peddie/leitshow/README.md

leitshow
========

Light show PCBs (and code?)
