peddie/leitshow/leit-proto-1.brd

## EAGLE design leit-proto-1.brd (2013-08-19)

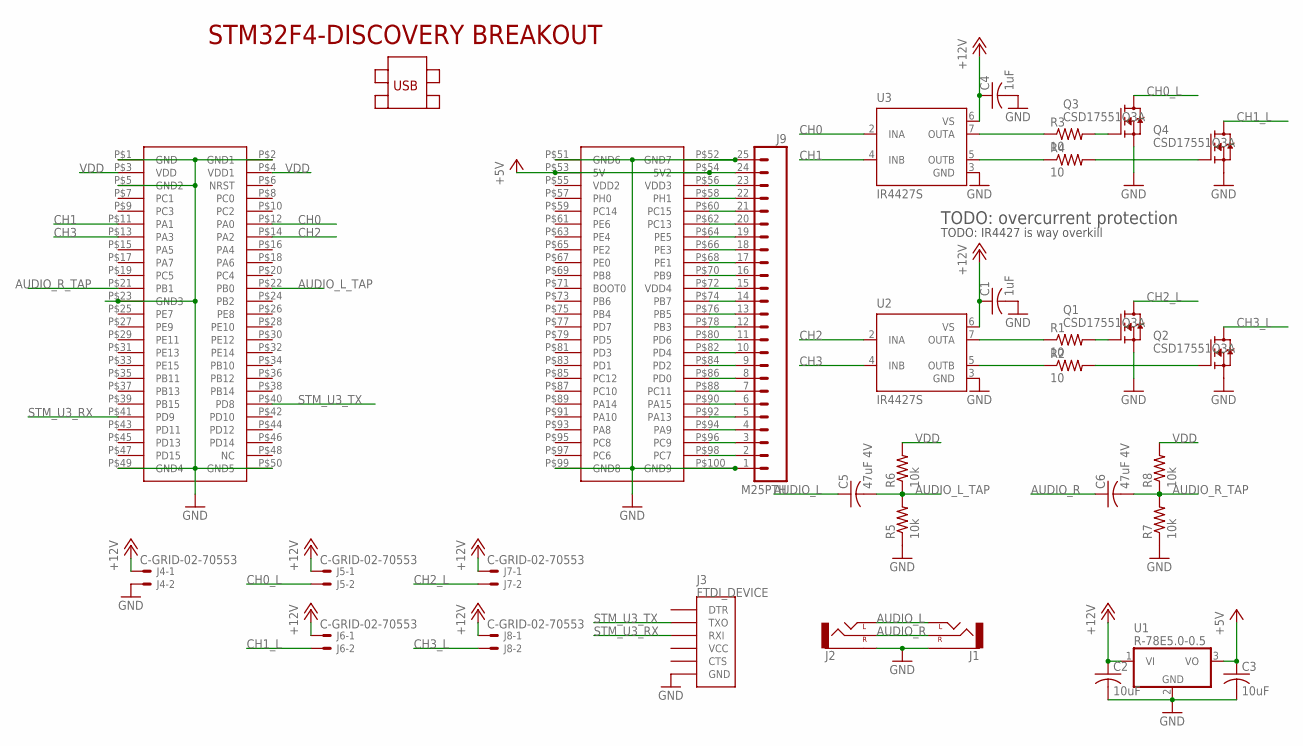
[picture p1: schematic leit-proto-1.sch]

Parts:
C1, C4: 1uF; C0603
C2, C3: 10uF; C0805
C5, C6: 47uF 4V; C0805
J1, J2: AUDIO-JACKPTH; AUDIO-JACK
J3: FTDI_DEVICE; FTDI_DEVICE_SIDE
J4, J5, J6, J7, J8: C-GRID-02-70553; 70553-02
J9: M25PTH; 1X25
MOD1: STM32F4-DISCOVERY
Q1, Q2, Q3, Q4: CSD17551Q3A; SON3.3
R1, R2, R3, R4: 10; R0603
R5, R6, R7, R8: 10k; R0603
U1: R-78E5.0-0.5; TO220V
U2, U3: IR4427S; SO08

Connections:
+5V: C3.1, J9.24, MOD1.P$53 (5V), MOD1.P$54 (5V2), U1.3 (VO)
+12V: C1.1, C2.1, C4.1, J4.1, J5.1, J6.1, J7.1, J8.1, U1.1 (VI), U2.6 (VS), U3.6 (VS)
AUDIO_L: C5.1, J1.TIP (LEFT), J2.TIP (LEFT)
AUDIO_L_TAP: C5.2, MOD1.P$22 (PB0), R5.2, R6.1
AUDIO_R: C6.1, J1.RING (RIGHT), J2.RING (RIGHT)
AUDIO_R_TAP: C6.2, MOD1.P$21 (PB1), R7.2, R8.1
CH0: MOD1.P$12 (PA0), U3.2 (INA)
CH0_L: J5.2, Q3.5 (D), Q3.6 (D), Q3.7 (D), Q3.8 (D)
CH1: MOD1.P$11 (PA1), U3.4 (INB)
CH1_L: J6.2, Q4.5 (D), Q4.6 (D), Q4.7 (D), Q4.8 (D)
CH2: MOD1.P$14 (PA2), U2.2 (INA)
CH2_L: J7.2, Q1.5 (D), Q1.6 (D), Q1.7 (D), Q1.8 (D)
CH3: MOD1.P$13 (PA3), U2.4 (INB)
CH3_L: J8.2, Q2.5 (D), Q2.6 (D), Q2.7 (D), Q2.8 (D)
GND: C1.2, C2.2, C3.2, C4.2, J1.SLEEVE, J2.SLEEVE, J3.P$6 (GND), J4.2, J9.1, J9.25, MOD1.P$1 (GND), MOD1.P$2 (GND1), MOD1.P$5 (GND2), MOD1.P$23 (GND3), MOD1.P$49 (GND4), MOD1.P$50 (GND5), MOD1.P$51 (GND6), MOD1.P$52 (GND7), MOD1.P$99 (GND8), MOD1.P$100 (GND9), Q1.1 (S), Q1.2 (S), Q1.3 (S), Q2.1 (S), Q2.2 (S), Q2.3 (S), Q3.1 (S), Q3.2 (S), Q3.3 (S), Q4.1 (S), Q4.2 (S), Q4.3 (S), R5.1, R7.1, U1.2 (GND), U2.3 (GND), U3.3 (GND)
unnamed: R1.1, U2.7 (OUTA)
unnamed: Q1.4 (G), R1.2
unnamed: Q2.4 (G), R2.2
unnamed: R2.1, U2.5 (OUTB)
unnamed: R3.1, U3.7 (OUTA)
unnamed: Q3.4 (G), R3.2
unnamed: Q4.4 (G), R4.2
unnamed: R4.1, U3.5 (OUTB)
unnamed: J9.2, MOD1.P$98 (PC7)
unnamed: J9.3, MOD1.P$96 (PC9)
unnamed: J9.4, MOD1.P$94 (PA9)
unnamed: J9.5, MOD1.P$92 (PA13)
unnamed: J9.6, MOD1.P$90 (PA15)
unnamed: J9.7, MOD1.P$88 (PC11)
unnamed: J9.8, MOD1.P$86 (PD0)
unnamed: J9.9, MOD1.P$84 (PD2)
unnamed: J9.10, MOD1.P$82 (PD4)
unnamed: J9.11, MOD1.P$80 (PD6)
unnamed: J9.12, MOD1.P$78 (PB3)
unnamed: J9.13, MOD1.P$76 (PB5)
unnamed: J9.14, MOD1.P$74 (PB7)
unnamed: J9.15, MOD1.P$72 (VDD4)
unnamed: J9.16, MOD1.P$70 (PB9)
unnamed: J9.17, MOD1.P$68 (PE1)
unnamed: J9.18, MOD1.P$66 (PE3)
unnamed: J9.19, MOD1.P$64 (PE5)
unnamed: J9.20, MOD1.P$62 (PC13)
unnamed: J9.21, MOD1.P$60 (PC15)
unnamed: J9.22, MOD1.P$58 (PH1)
unnamed: J9.23, MOD1.P$56 (VDD3)
STM_U3_RX: J3.P$3 (RXI), MOD1.P$41 (PD9)
STM_U3_TX: J3.P$2 (TXO), MOD1.P$40 (PD8)
VDD: MOD1.P$3 (VDD), MOD1.P$4 (VDD1), R6.2, R8.2

Notes on the sheet:
TODO: overcurrent protection
TODO: IR4427 is way overkill

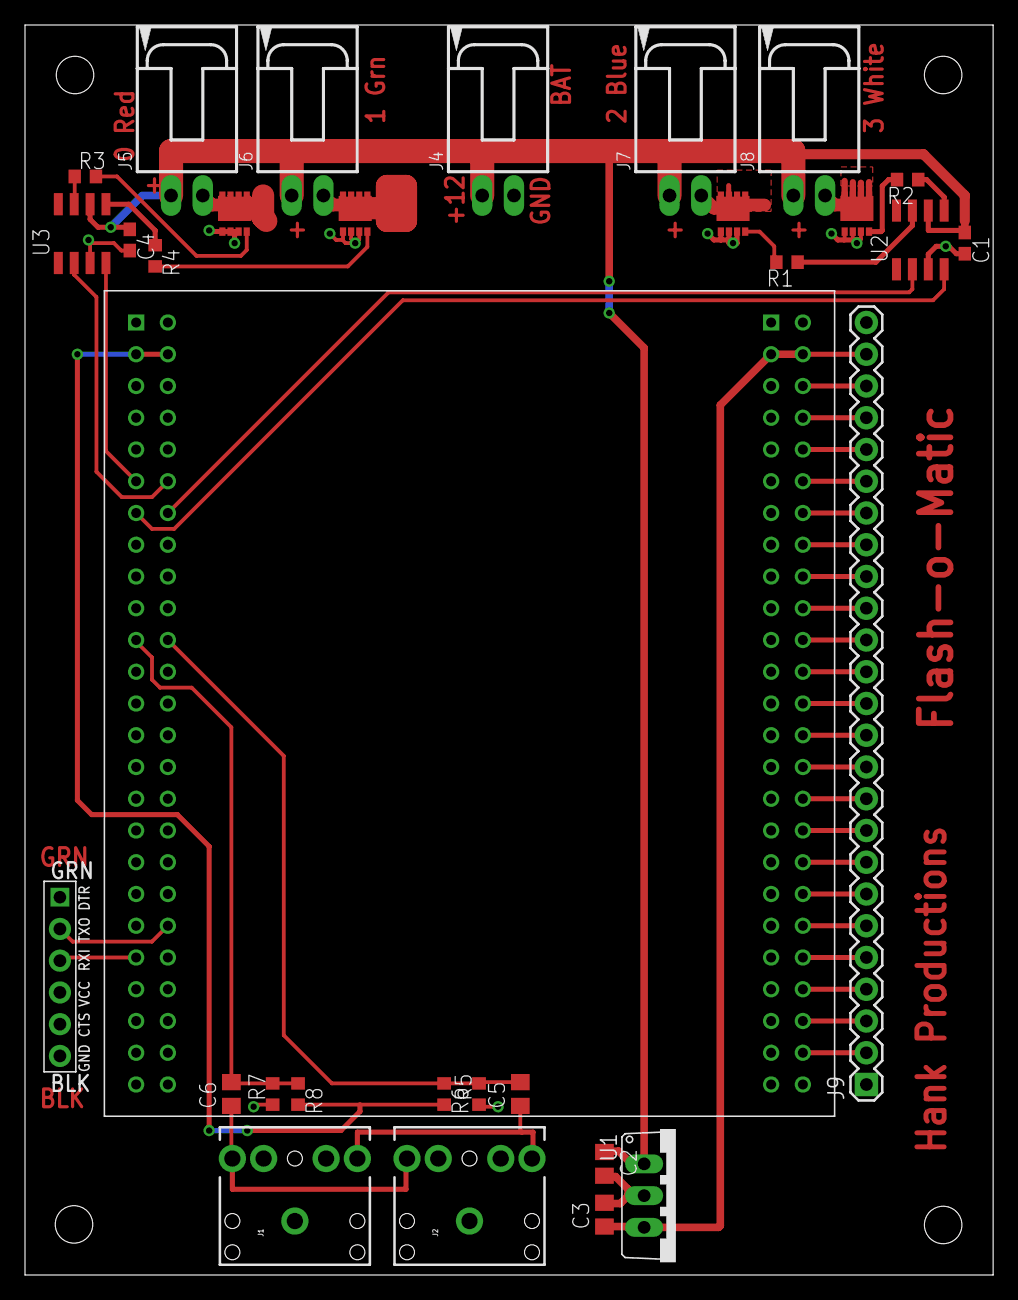
[picture p2: board leit-proto-1.brd from above]

Board: 2 copper layers, 77.5 x 100.0 mm, 31 parts (0 on the bottom side), 48 nets.
