peddie/leitshow/(commit log)

2013-08-19 schematic complete for first prototype
    [leit-proto-1.brd, leit-proto-1.sch]
2013-08-19 PCB layout complete for barebones proto
    [leit-proto-1.brd, leit-proto-1.sch]
2013-08-19 Add BOM for prototype
    [proto1_bom.csv]
2013-08-24 better solder paste for transistor?
2013-08-25 leitshow prototypes
2013-08-25 Add filterbank code for Cortex-M4 using CMSIS (kind of crappy)
2013-08-25 filter init
2013-08-25 Always print out sample time to avoid confusion
2013-08-25 A quick test program for the filter bank.
2013-08-25 This doesn't need to be so fast.
    [analysis.c]
